Kaldek/Verada-Steering-Controls-Interceptor/(commit log)

2024-01-21 Create PD6134-Arduino-decoder
2024-11-14 Alternative code to test noise handling
    Noise from other steering wheel controls (mainly the indicators) is causing the code to re-trigger the last digital potentiometer setting. This code is being used to test some software methods to resolve this before a hardware solution is attempted.
    [PC6134-Arduino-Decoder-NoiseHandling.ino]
2024-11-14 Added "current issues" section.
